MaxenceHeroux/H2GP-2026/README.md

View this project on [CADLAB.io](https://cadlab.io/project/30325). 

# H2GP-2026
