MaxenceHeroux/H2GP-2026/PCB/H30_controler_board.kicad_pcb

## KiCad design PCB/H30_controler_board.kicad_pcb (2026-05-22)

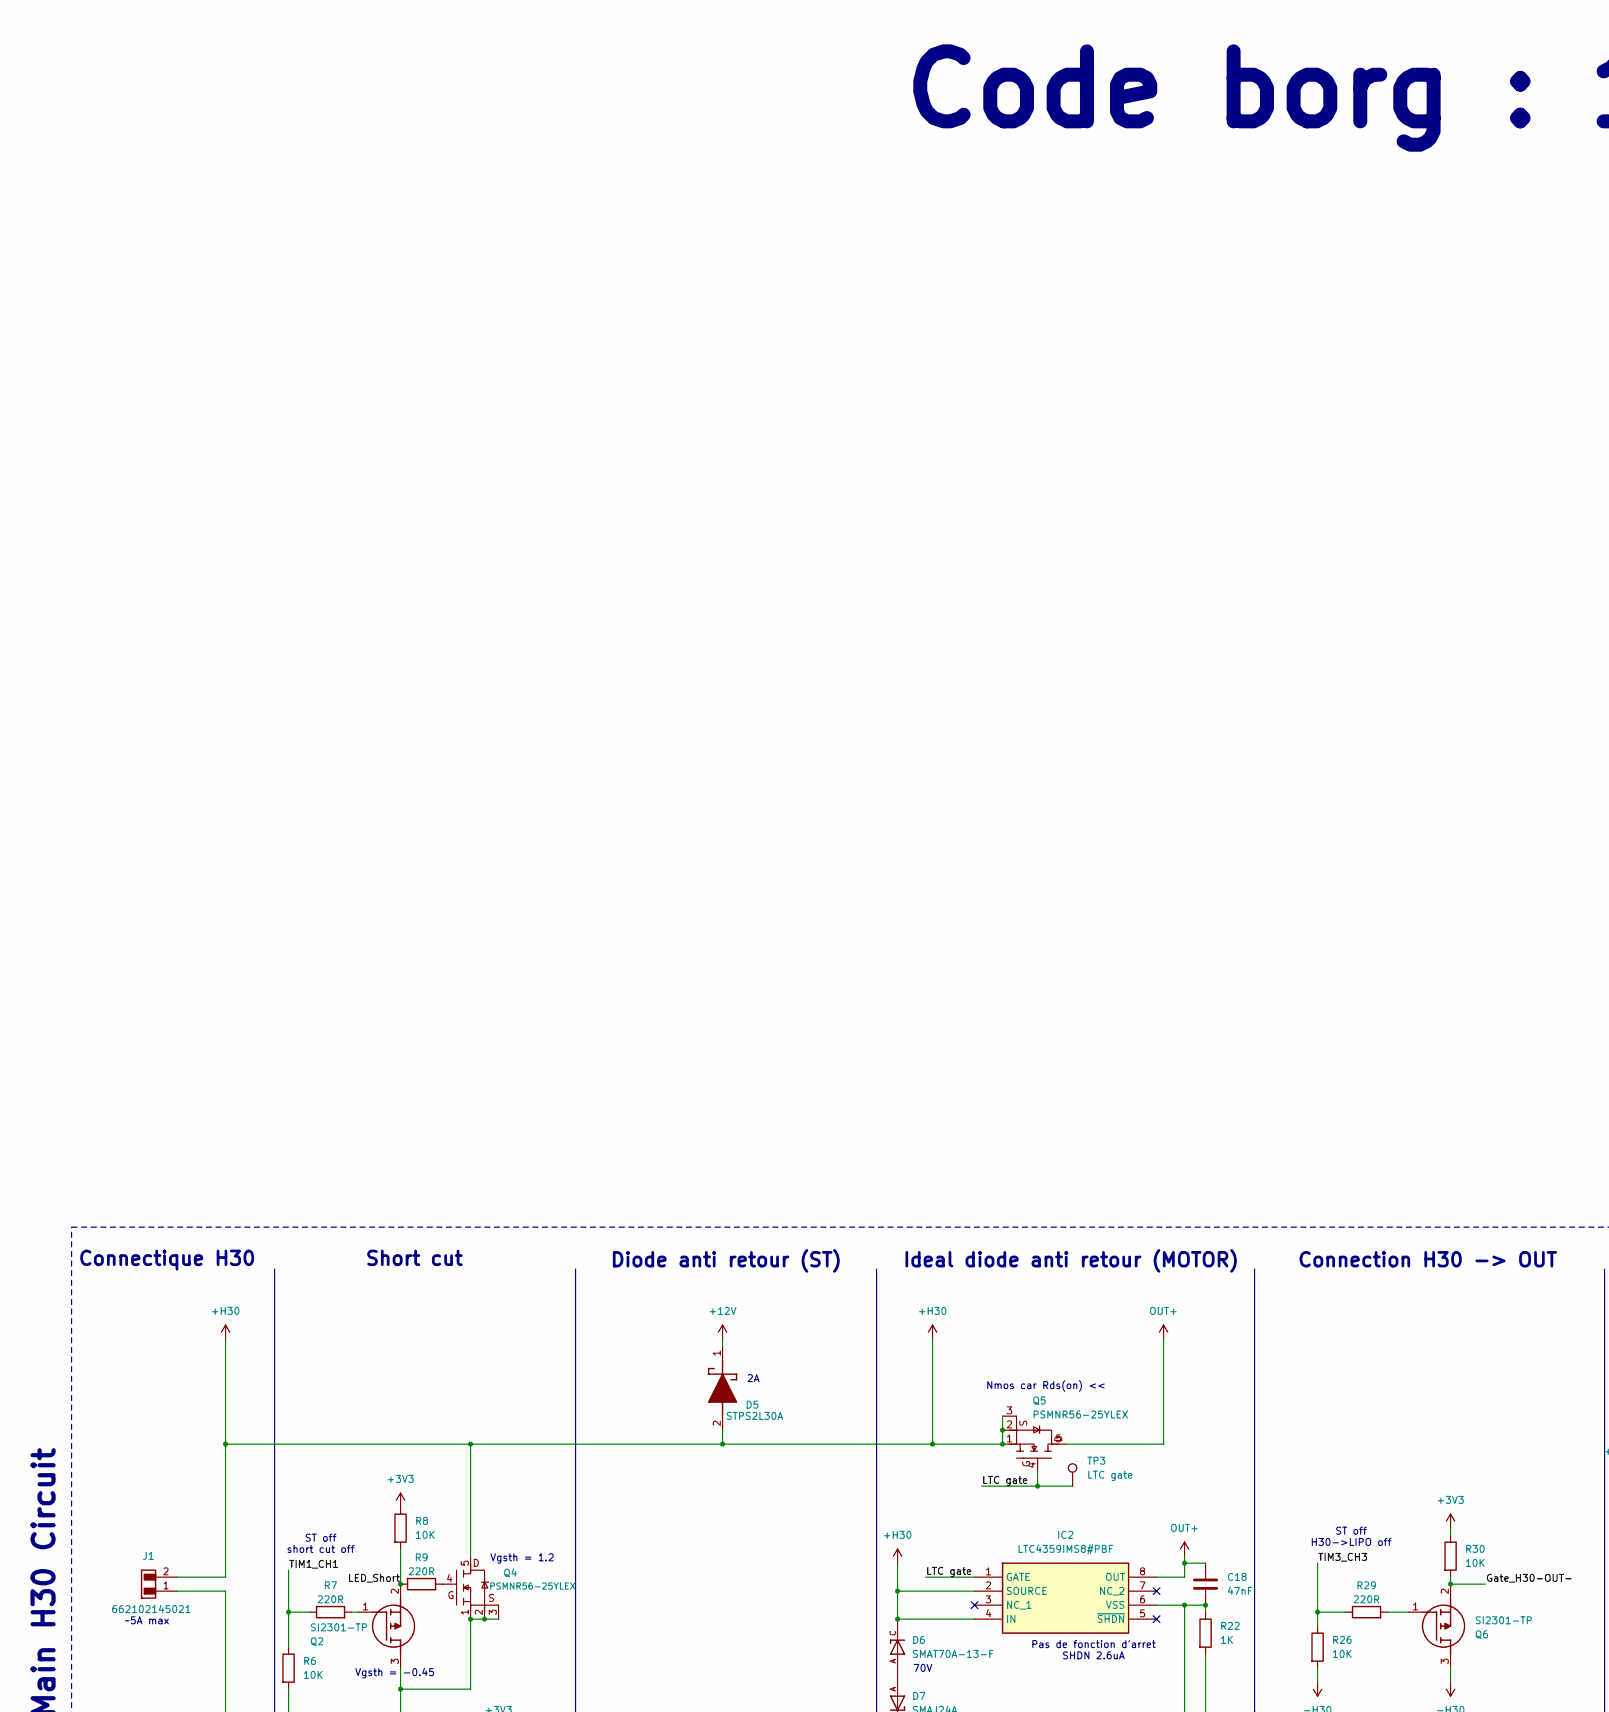
[picture p1: schematic H30_controler_board.kicad_sch, Manager for H30 hydrogene stack, part in row 1, column 1]

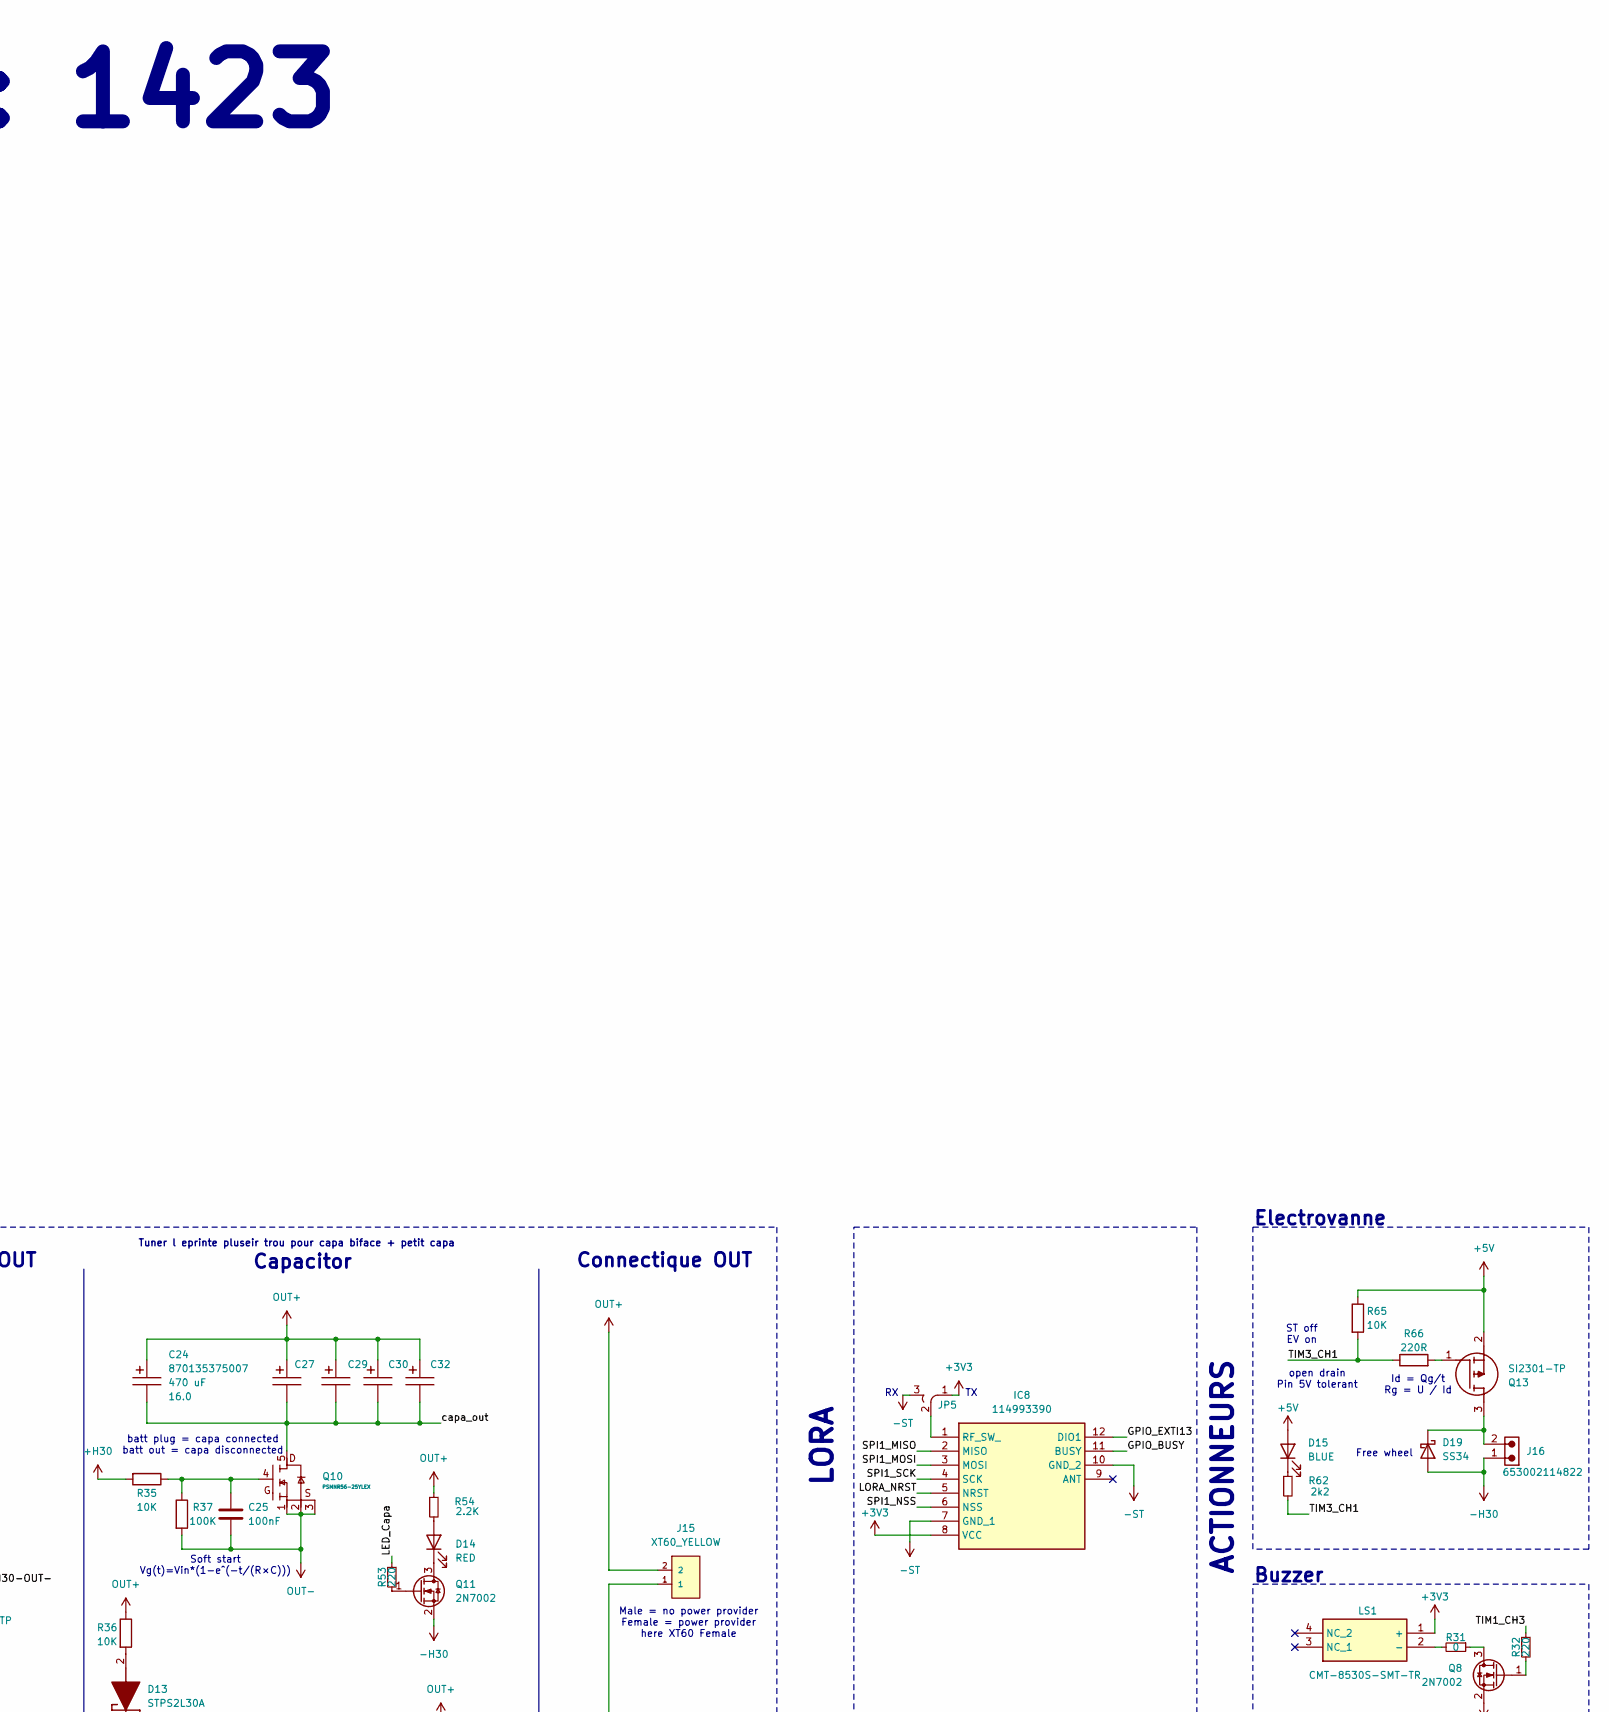
[picture p2: schematic H30_controler_board.kicad_sch, Manager for H30 hydrogene stack, part in row 1, column 2]

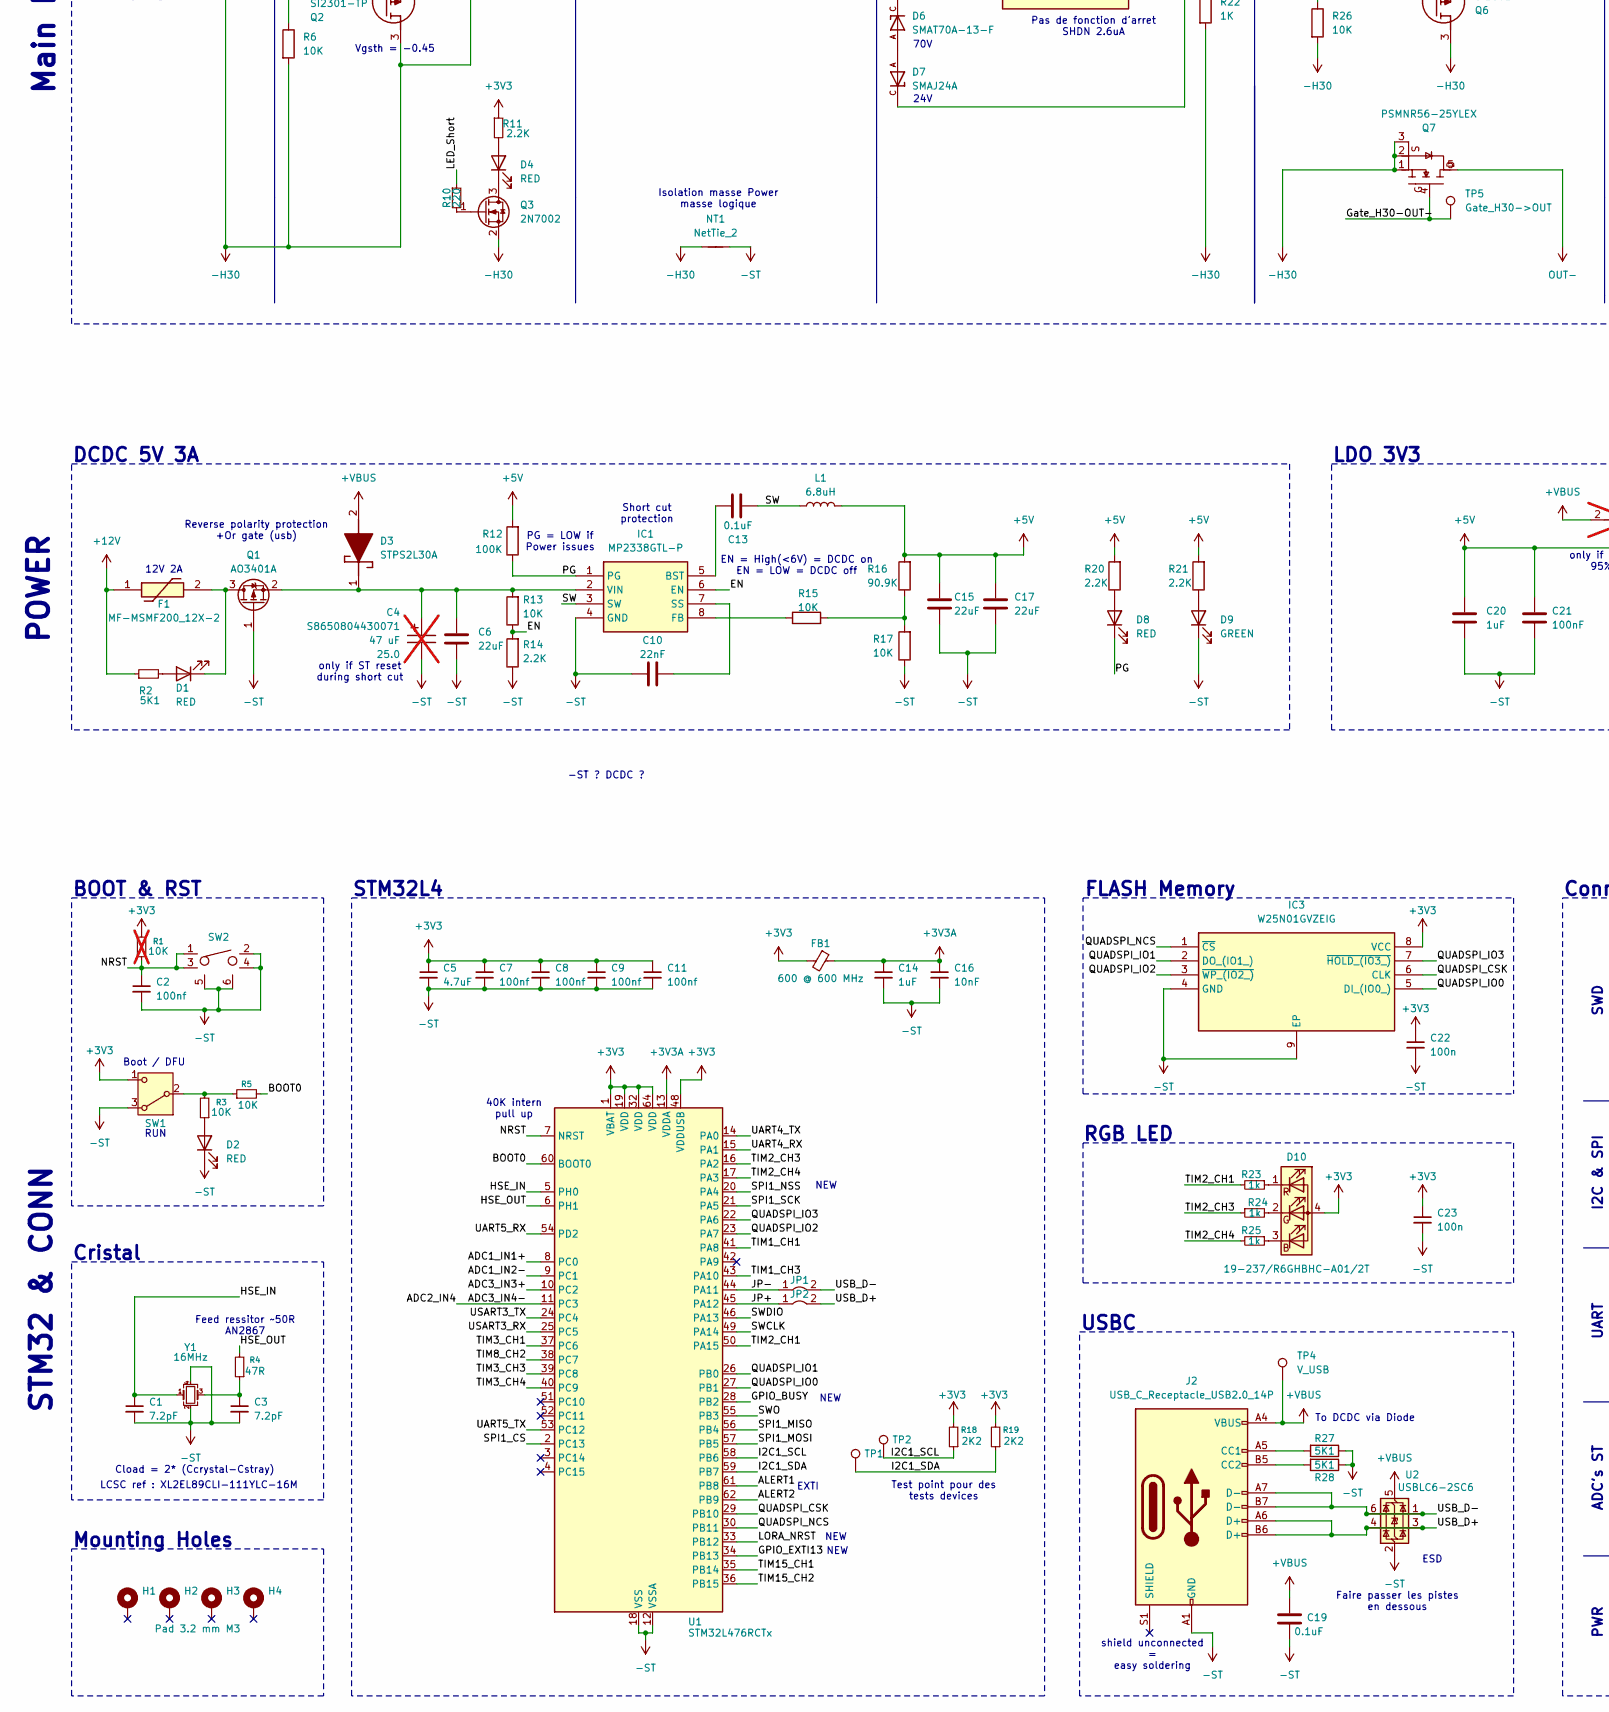
[picture p3: schematic H30_controler_board.kicad_sch, Manager for H30 hydrogene stack, part in row 2, column 1]

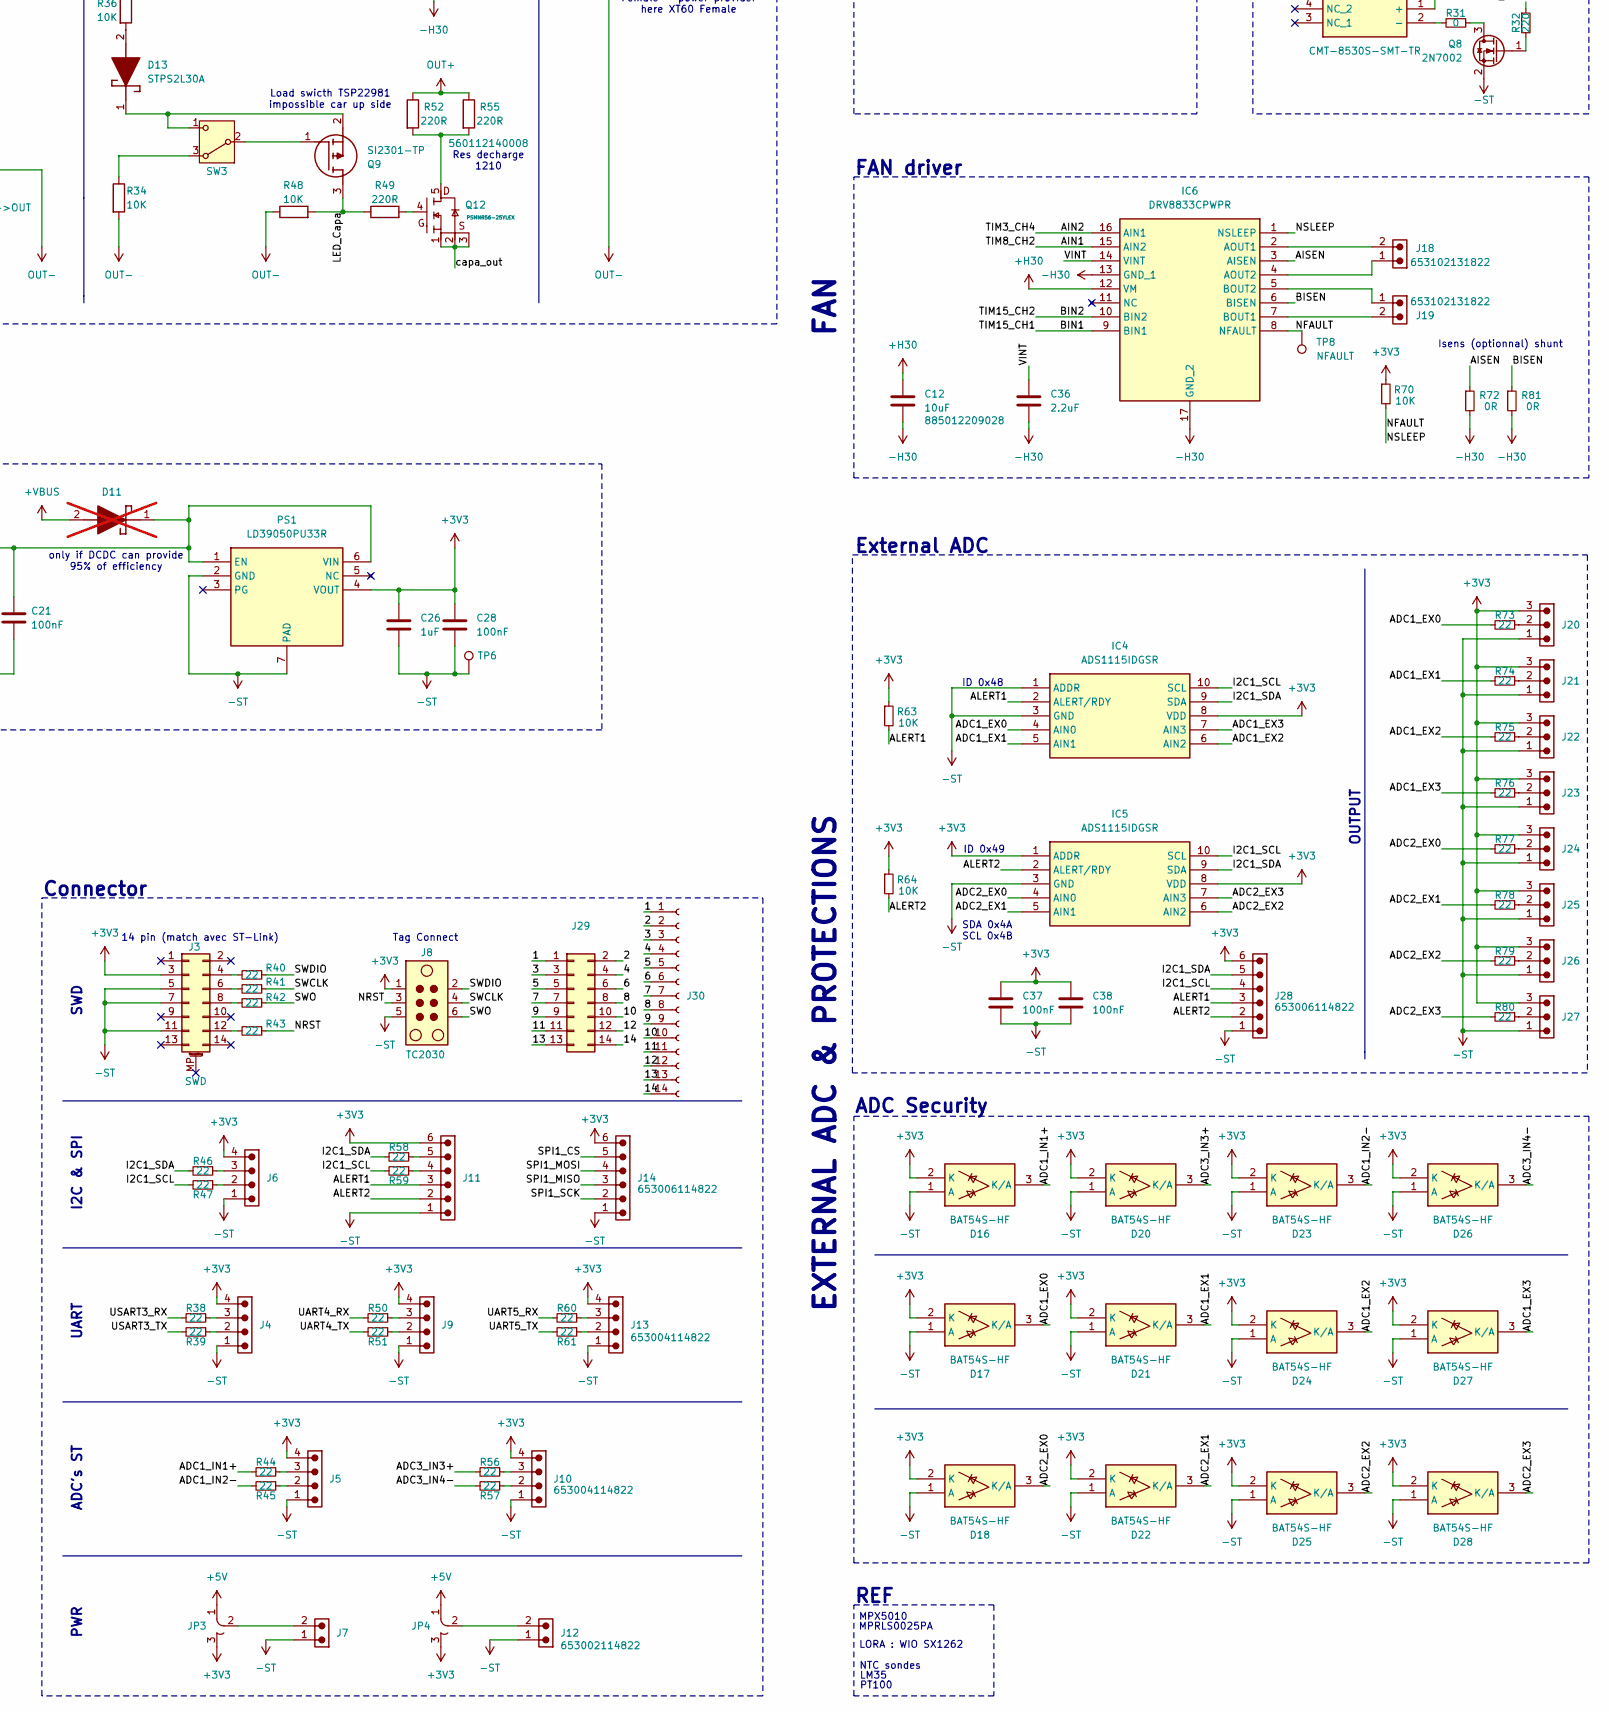
[picture p4: schematic H30_controler_board.kicad_sch, Manager for H30 hydrogene stack, part in row 2, column 2]

Parts:
C1, C3: 7.2pF; C_0603_1608Metric
C2, C7, C9, C11: 100nf; C_0603_1608Metric
C4: 47 uF; CP_Wurth_WCAP-ASLI-D6.3L5.5; Voltage 25.0; Part Number S8650804430071; not fitted
C5: 4.7uF; C_0603_1608Metric
C6, C15, C17: 22uF; C_0603_1608Metric
C8: 100nf; C_0402_1005Metric
C10: 22nF; C_0603_1608Metric
C12: 10uF; C_1210_3225Metric
C13, C19: 0.1uF; C_0603_1608Metric
C14, C20, C26: 1uF; C_0603_1608Metric
C16: 10nF; C_0603_1608Metric
C18: 47nF; C_0603_1608Metric
C21, C25, C28, C37, C38: 100nF; C_0603_1608Metric
C22, C23: 100n; C_0603_1608Metric; LCSC Part # C1525
C24, C27, C29, C30, C32: 470 uF; CP_Wurth_WCAP-PTHT-P5D10L12.5; Voltage 16.0; Part Number 870135375007
C36: 2.2uF; C_0603_1608Metric
D1, D2, D4, D8, D14: RED; LED_0603_1608Metric
D3, D5, D13: STPS2L30A; DIOM5126X265N; Mouser Part Number 511-STPS2L30A
D6: SMAT70A-13-F; DIOM5226X230N; PARTREV 11 - 2
D7: SMAJ24A; DIOM4325X250N; PARTREV S2102
D9: GREEN; LED_0603_1608Metric
D10: 19-237/R6GHBHC-A01/2T; 19237R6GHBHCA012T; LCSC Part # C60105
D11: STPS2L30A; DIOM5126X265N; Mouser Part Number 511-STPS2L30A; not fitted
D15: BLUE; LED_0603_1608Metric
D16, D17, D18, D20, D21, D22, D23, D24, D25, D26, D27, D28: BAT54S-HF; SOT95P240X115-3N; Mouser Part Number 750-BAT54S-HF
D19: SS34; D_SMA
F1: MF-MSMF200_12X-2; MFMSMF20012X2; Manufacturer_Part_Number MF-MSMF200/12X-2
FB1: 600 @ 600 MHz; L_0805_2012Metric; LCSC Part # C1017
H1, H2, H4: MountingHole_Pad; MountingHole_3.2mm_M3_Pad_Via
H3: Pad 3.2 mm M3; MountingHole_3.2mm_M3_Pad_Via
IC1: MP2338GTL-P; SOTFL50P160X60-8N; Mouser Part Number 946-MP2338GTL-P
IC2: LTC4359IMS8#PBF; SOP65P490X110-8N; Mouser Part Number 584-LTC4359IMS8#PBF
IC3: W25N01GVZEIG; SON127P800X600X80-9N-D; Mouser Part Number 454-W25N01GVZEIG
IC4, IC5: ADS1115IDGSR; SOP50P490X110-10N; Mouser Part Number 595-ADS1115IDGSR
IC6: DRV8833CPWPR; SOP65P640X120-17N; Mouser Part Number 595-DRV8833CPWPR
IC8: 114993390; Mouser Part Number 713-114993390
J1: 662102145021; J_Wurth_WR-MPC3_662102145021; Working Voltage (V (AC)) 250
J2: USB_C_Receptacle_USB2.0_14P; USBC
J3: SWD; PinHeader_2x07_P1.27mm_Vertical
J4, J5, J6, J9, J10, J13: 653004114822; J_Wurth_WR-WTB_653004114822; Working Voltage (V (AC)) 125
J7, J12, J16: 653002114822; J_Wurth_WR-WTB_653002114822; Working Voltage (V (AC)) 125
J8: TC2030; Tag-Connect_TC2030-IDC-NL_2x03_P1.27mm_Vertical
J11, J14, J28: 653006114822; J_Wurth_WR-WTB_653006114822; Working Voltage (V (AC)) 125
J15: XT60_YELLOW; AMASS_XT60PB-F; PARTREV 1.2
J18, J19: 653102131822; J_Wurth_WR-WTB_653102131822; Working Voltage (V (AC)) 125
J20, J21, J22, J23, J24, J25, J26, J27: 653003114822; J_Wurth_WR-WTB_653003114822; Working Voltage (V (AC)) 125
J29: Conn_02x07_Odd_Even; PinSocket_2x07_P1.27mm_Vertical
J30: Conn_01x14_Socket; PinSocket_2x07_P2.54mm_Vertical
JP1, JP2: Jumper_0603
JP3, JP4, JP5: Jumper_3points_0402
L1: 6.8uH; INDPM5752X200N
LS1: CMT-8530S-SMT-TR; CMT8530SSMTTR; Mouser Part Number 490-CMT-8530S-SMT-TR
NT1: NetTie_2; NetTie-2_SMD_Pad2.0mm
PS1: LD39050PU33R; SON95P300X300X100-7N-D; Mouser Part Number 511-LD39050PU33R
Q1: AO3401A; SOT-23
Q2, Q6, Q9, Q13: SI2301-TP; SOT95P237X125-3N; Mouser Part Number 833-SI2301-TP
Q3, Q8, Q11: 2N7002; SOT-23
Q4, Q5, Q7, Q10, Q12: PSMNR56-25YLEX; PSMNR5830YLHX
R1: 10K; R_0402_1005Metric; not fitted
R2: 5K1; R_0603_1608Metric; LCSC Part # C25092
R3, R5, R6, R8, R13, R15, R17, R26, R30, R34, R35, R36, R48, R65: 10K; R_0603_1608Metric
R4: 47R; R_0603_1608Metric
R7, R9, R29, R49, R66: 220R; R_0603_1608Metric
R10, R32, R53: 220; R_0603_1608Metric; LCSC Part # C25092
R11, R54: 2.2K; R_0603_1608Metric; LCSC Part # C25092
R12, R37: 100K; R_0603_1608Metric
R14, R20, R21: 2.2K; R_0603_1608Metric
R16: 90.9K; R_0603_1608Metric
R18, R19: 2K2; R_0603_1608Metric
R22: 1K; R_0603_1608Metric
R23, R24, R25: 1k; R_0603_1608Metric; LCSC Part # C11702
R27, R28: 5K1; R_0603_1608Metric
R31: 0; R_0603_1608Metric; LCSC Part # C25092
R38, R39, R40, R41, R42, R43, R44, R45, R46, R47, R50, R51, R56, R57, R58, R59, R60, R61, R73, R74, R75, R76, R77, R78, R79, R80: 22; R_0402_1005Metric; LCSC Part # C25092
R52, R55: 220R; R_1210_3225Metric
R62: 2k2; R_0603_1608Metric; LCSC Part # C25092
R63, R64, R70: 10K; R_0603_1608Metric; LCSC Part # C25092
R72, R81: 0R; R_0603_1608Metric; LCSC Part # C25092
SW1, SW3: SW_Nidec_CAS-120A1; 450404015514
SW2: SKSG
TP1: SDA; TestPoint_Pad_D1.5mm
TP2: SCL; TestPoint_Pad_D1.5mm
TP3: LTC gate; TestPoint_Pad_D1.5mm
TP4: V_USB; TestPoint_Pad_D1.5mm
TP5: Gate_H30->OUT; TestPoint_Pad_D1.5mm
TP6: V_Reverse; TestPoint_Pad_D1.5mm
TP8: NFAULT; TestPoint_Pad_D1.5mm
U1: STM32L476RCTx; LQFP-64_10x10mm_P0.5mm
U2: USBLC6-2SC6; SOT-23-6
Y1: 16MHz; NX3225SA16000000MHZB3

Connections:
+3V3: C5.1, C7.1, C8.1, C9.1, C11.1, C22.1, C23.1, C26.1, C28.1, C37.1, C38.1, D10.4 (A), D16.2 (K), D17.2 (K), D18.2 (K), D20.2 (K), D21.2 (K), D22.2 (K), D23.2 (K), D24.2 (K), D25.2 (K), D26.2 (K), D27.2 (K), D28.2 (K), FB1.2, IC3.8 (VCC), IC4.8 (VDD), IC5.1 (ADDR), IC5.8 (VDD), IC8.8 (VCC), J3.3, J4.4, J5.4, J6.4, J8.1, J9.4, J10.4, J11.6, J13.4, J14.6, J20.3, J21.3, J22.3, J23.3, J24.3, J25.3, J26.3, J27.3, J28.6, JP3.3, JP4.3, JP5.1, LS1.1 (+), PS1.4 (VOUT), R1.2, R8.1, R11.1, R18.2, R19.2, R30.1, R63.1, R64.1, R70.1, SW1.1 (C), U1.1 (VBAT), U1.19 (VDD), U1.32 (VDD), U1.48 (VDDUSB), U1.64 (VDD); also elsewhere on the board
+3V3A: C14.1, C16.1, FB1.1, U1.13 (VDDA)
+5V: C15.1, C17.1, C20.1, C21.1, D11.1 (K), D15.2 (A), JP3.1, JP4.1, L1.2, PS1.1 (EN), PS1.6 (VIN), Q13.2 (S), R12.2, R16.2, R20.2, R21.2, R65.1
+12V: D5.1 (K), F1.1, R2.1
+H30: C12.1, D5.2 (A), D6.C, IC2.2 (SOURCE), IC2.4 (IN), IC6.12 (VM), J1.2, Q4.5 (D), Q4.6, Q5.1 (S), Q5.2 (S), Q5.3 (S), R35.2
+VBUS: C19.1, D3.2 (A), D11.2 (A), J2.A4 (VBUS), J2.A9 (VBUS), J2.B4 (VBUS), J2.B9 (VBUS), TP4.1, U2.5 (VBUS)
-H30: C12.2, C36.2, D19.2 (A), IC6.13 (GND_1), IC6.17 (GND_2), J1.1, J16.1, J19.MP1, NT1.2, Q2.3 (D), Q3.2 (S), Q4.1 (S), Q4.2 (S), Q4.3 (S), Q6.3 (D), Q7.1 (S), Q7.2 (S), Q7.3 (S), Q11.2 (S), R6.2, R22.2, R26.2, R72.2, R81.2
-ST: C1.2, C2.2, C3.2, C4.2, C5.2, C6.2, C7.2, C8.2, C9.2, C10.2, C11.2, C14.2, C15.2, C16.2, C17.2, C19.2, C20.2, C21.2, C22.2, C23.2, C26.2, C28.2, C37.2, C38.2, D2.1 (K), D9.1 (K), D16.1 (A), D17.1 (A), D18.1 (A), D20.1 (A), D21.1 (A), D22.1 (A), D23.1 (A), D24.1 (A), D25.1 (A), D26.1 (A), D27.1 (A), D28.1 (A), IC1.4 (GND), IC3.4 (GND), IC3.9 (EP), IC4.1 (ADDR), IC4.3 (GND), IC5.3 (GND), IC8.7 (GND_1), IC8.10 (GND_2), J2.A1 (GND), J2.A12 (GND), J2.B1 (GND), J2.B12 (GND), J3.5, J3.7, J3.11, J4.1, J5.1, J6.1, J7.1, J8.5, J9.1, J10.1, J11.1, J12.1, J13.1, J14.1, J20.1, J21.1, J22.1, J23.1, J24.1, J25.1, J26.1, J27.1, J28.1, JP5.3, NT1.1, PS1.2 (GND), PS1.7 (PAD), Q1.1 (G), Q8.2 (S), R14.1, R17.1, R27.1, R28.1, SW1.3 (A), SW2.2, SW2.4, SW2.5, SW2.6, TP6.1, U1.12 (VSSA), U1.18 (VSS), U1.31 (VSS), U1.47 (VSS), U1.63 (VSS), U2.2 (GND), Y1.2, Y1.4
/1: J29.1, J30.1
/2: J29.2, J30.2
/3: J29.3, J30.3
/4: J29.4, J30.4
/5: J29.5, J30.5
/6: J29.6, J30.6
/7: J29.7, J30.7
/8: J29.8, J30.8
/9: J29.9, J30.9
/10: J29.10, J30.10
/11: J29.11, J30.11
/12: J29.12, J30.12
/13: J29.13, J30.13
/14: J29.14, J30.14
/ADC1_EX0: D17.3 (K/A), IC4.4 (AIN0), R73.2
/ADC1_EX1: D21.3 (K/A), IC4.5 (AIN1), R74.2
/ADC1_EX2: D24.3 (K/A), IC4.6 (AIN2), R75.2
/ADC1_EX3: D27.3 (K/A), IC4.7 (AIN3), R76.2
/ADC1_IN1+: D16.3 (K/A), R44.2, U1.8 (PC0)
/ADC1_IN2-: D23.3 (K/A), R45.2, U1.9 (PC1)
/ADC2_EX0: D18.3 (K/A), IC5.4 (AIN0), R77.2
/ADC2_EX1: D22.3 (K/A), IC5.5 (AIN1), R78.2
/ADC2_EX2: D25.3 (K/A), IC5.6 (AIN2), R79.2
/ADC2_EX3: D28.3 (K/A), IC5.7 (AIN3), R80.2
/ADC2_IN4: D26.3 (K/A), R57.2, U1.11 (PC3)
/ADC3_IN3+: D20.3 (K/A), R56.2, U1.10 (PC2)
/AIN1: IC6.15 (AIN2), U1.38 (PC7)
/AIN2: IC6.16 (AIN1), U1.40 (PC9)
/AISEN: IC6.3 (AISEN), R72.1
/ALERT1: IC4.2 (ALERT/RDY), J11.3, J28.3, R63.2, U1.61 (PB8)
/ALERT2: IC5.2 (ALERT/RDY), J11.2, J28.2, R64.2, U1.62 (PB9)
/BIN1: IC6.9 (BIN1), U1.35 (PB14)
/BIN2: IC6.10 (BIN2), U1.36 (PB15)
/BISEN: IC6.6 (BISEN), R81.1
/BOOT0: R5.2, U1.60 (BOOT0)
/EN: IC1.6 (EN), R13.1, R14.2
/GPIO_BUSY: IC8.11 (BUSY), U1.28 (PB2)
/GPIO_EXTI13: IC8.12 (DIO1), U1.34 (PB13)
/Gate_H30-OUT-: Q6.2 (S), Q7.4 (G), R30.2, TP5.1
/HSE_IN: C1.1, U1.5 (PH0), Y1.1
/HSE_OUT: R4.2, U1.6 (PH1)
/I2C1_SCL: IC4.10 (SCL), IC5.10 (SCL), J28.4, R18.1, R47.2, R59.2, TP2.1, U1.58 (PB6); also elsewhere on the board
/I2C1_SDA: IC4.9 (SDA), IC5.9 (SDA), J28.5, R19.1, R46.2, R58.2, TP1.1, U1.59 (PB7); also elsewhere on the board
/JP+: JP2.1, U1.45 (PA12)
/JP-: JP1.1, U1.44 (PA11)
/LED_Capa: Q9.3 (D), R48.2, R49.1, R53.1
/LED_Short: Q2.2 (S), R8.2, R9.1, R10.1
/LORA_NRST: IC8.5 (NRST), U1.33 (PB12)
/LTC gate: IC2.1 (GATE), Q5.4 (G), TP3.1
/NFAULT: IC6.1 (NSLEEP), IC6.8 (NFAULT), R70.2, TP8.1
/NRST: C2.1, J8.3, R1.1, R43.1, SW2.1, SW2.3, U1.7 (NRST)
/PG: D8.1 (K), IC1.1 (PG), R12.1
/QUADSPI_CSK: IC3.6 (CLK), U1.29 (PB10)
/QUADSPI_IO0: IC3.5 (DI_(IO0_)), U1.27 (PB1)
/QUADSPI_IO1: IC3.2 (DO_(IO1_)), U1.26 (PB0)
/QUADSPI_IO2: IC3.3 (~WP_(IO2_)), U1.23 (PA7)
/QUADSPI_IO3: IC3.7 (~HOLD_(IO3_)), U1.22 (PA6)
/QUADSPI_NCS: IC3.1 (~CS), U1.30 (PB11)
/SPI1_CS: J14.5, U1.2 (PC13)
/SPI1_MISO: IC8.2 (MISO), J14.3, U1.56 (PB4)
/SPI1_MOSI: IC8.3 (MOSI), J14.4, U1.57 (PB5)
/SPI1_NSS: IC8.6 (NSS), U1.20 (PA4)
/SPI1_SCK: IC8.4 (SCK), J14.2, U1.21 (PA5)
/SW: C13.2, IC1.3 (SW), L1.1
/SWCLK: J8.4, R41.1, U1.49 (PA14)
/SWDIO: J8.2, R40.1, U1.46 (PA13)
/SWO: J8.6, R42.1, U1.55 (PB3)
/TIM1_CH1: R6.1, R7.1, U1.41 (PA8)
/TIM1_CH3: R32.1, U1.43 (PA10)
/TIM2_CH1: R23.2, U1.50 (PA15)
/TIM2_CH3: R24.1, U1.16 (PA2)
/TIM2_CH4: R25.2, U1.17 (PA3)
/TIM3_CH1: R62.2, R65.2, R66.1, U1.37 (PC6)
/TIM3_CH3: R26.1, R29.1, U1.39 (PC8)
/UART4_RX: R50.2, U1.15 (PA1)
/UART4_TX: R51.2, U1.14 (PA0)
/UART5_RX: R60.2, U1.54 (PD2)
/UART5_TX: R61.2, U1.53 (PC12)
/USART3_RX: R38.2, U1.25 (PC5)
/USART3_TX: R39.2, U1.24 (PC4)
/USB_D+: J2.A6 (D+), J2.B6 (D+), JP2.2, U2.3 (I/O2), U2.4 (I/O2)
/USB_D-: J2.A7 (D-), J2.B7 (D-), JP1.2, U2.1 (I/O1), U2.6 (I/O1)
/VINT: C36.1, IC6.14 (VINT)
/capa_out: C24.2, C27.2, C29.2, C30.2, C32.2, Q10.5 (D), Q10.6, Q12.1 (S), Q12.2 (S), Q12.3 (S)
unnamed: C3.1, R4.1, Y1.3
unnamed: D1.2 (A), R2.2
unnamed: D1.1 (K), F1.2, Q1.3 (D)
unnamed: D2.2 (A), R3.1
unnamed: C4.1, C6.1, D3.1 (K), IC1.2 (VIN), Q1.2 (S), R13.2
unnamed: D4.2 (A), R11.2
unnamed: D4.1 (K), Q3.3 (D)
unnamed: D6.A, D7.A
unnamed: D8.2 (A), R20.1
unnamed: D9.2 (A), R21.1
unnamed: D10.3 (BK), R25.1
unnamed: D10.2 (GK), R24.2
unnamed: D10.1 (RK), R23.1
unnamed: D13.2 (A), R36.2
unnamed: D13.1 (K), Q9.2 (S), SW3.1 (C)
unnamed: D14.2 (A), R54.2
unnamed: D14.1 (K), Q11.3 (D)
unnamed: D15.1 (K), R62.1
unnamed: D19.1 (K), J16.2, Q13.3 (D)
unnamed: C13.1, IC1.5 (BST)
unnamed: IC1.8 (FB), R15.1
unnamed: C10.1, IC1.7 (SS)
unnamed: C18.2, D7.C, IC2.6 (VSS), R22.1
unnamed: IC6.2 (AOUT1), J18.2
unnamed: IC6.4 (AOUT2), J18.1
unnamed: IC6.7 (BOUT1), J19.2
unnamed: IC6.5 (BOUT2), J19.1
unnamed: IC8.1 (RF_SW_), JP5.2
unnamed: J2.A5 (CC1), R27.2
unnamed: J2.B5 (CC2), R28.2
unnamed: J3.4, R40.2
unnamed: J3.6, R41.2
unnamed: J3.8, R42.2
unnamed: J3.12, R43.2
unnamed: J4.2, R39.1
unnamed: J4.3, R38.1
unnamed: J5.2, R45.1
unnamed: J5.3, R44.1
unnamed: J6.2, R47.1
unnamed: J6.3, R46.1
unnamed: J7.2, JP3.2
unnamed: J9.2, R51.1
unnamed: J9.3, R50.1
unnamed: J10.2, R57.1
unnamed: J10.3, R56.1
unnamed: J11.4, R59.1
unnamed: J11.5, R58.1
unnamed: J12.2, JP4.2
unnamed: J13.2, R61.1
unnamed: J13.3, R60.1
unnamed: J20.2, R73.1
unnamed: J21.2, R74.1
unnamed: J22.2, R75.1
unnamed: J23.2, R76.1
unnamed: J24.2, R77.1
unnamed: J25.2, R78.1
unnamed: J26.2, R79.1
unnamed: J27.2, R80.1
unnamed: LS1.2 (-), R31.2
unnamed: Q2.1 (G), R7.2
unnamed: Q3.1 (G), R10.2
unnamed: Q4.4 (G), R9.2
unnamed: Q6.1 (G), R29.2
unnamed: Q8.3 (D), R31.1
unnamed: Q8.1 (G), R32.2
unnamed: Q9.1 (G), SW3.2 (B)
unnamed: C25.1, Q10.4 (G), R35.1, R37.1
unnamed: Q11.1 (G), R53.2
unnamed: Q12.5 (D), Q12.6, R52.2, R55.2
unnamed: Q12.4 (G), R49.2
unnamed: Q13.1 (G), R66.2
unnamed: R15.2, R16.1, R17.2
unnamed: R3.2, R5.1, SW1.2 (B)
unnamed: R34.1, SW3.3 (A)
OUT+: C18.1, C24.1, C27.1, C29.1, C30.1, C32.1, IC2.8 (OUT), J15.2, LS1.3 (NC_1), Q5.5 (D), Q5.6, R36.1, R52.1, R54.1, R55.1
OUT-: C25.2, J15.1, Q7.5 (D), Q7.6, Q10.1 (S), Q10.2 (S), Q10.3 (S), R34.2, R37.2, R48.1

Notes on the sheet:
Faire passer les pistes en dessous
OUTPUT
Nmos car Rds(on) <<
Boot / DFU
Isolation masse Power masse logique
Tag Connect
SWD
shield unconnected = easy soldering
ID 0x49
ID 0x48
To DCDC via Diode
ST off EV on
Code borg : 1423
EXTI
PWR
Electrovanne
Reverse polarity protection +Or gate (usb)
Connectique OUT
Short cut
Res decharge 1210
Main H30 Circuit
MPRLS0025PA
LORA
12V 2A
only if DCDC can provide 95% of efficiency
Mounting Holes
LM35
NEW
Cload = 2* (Ccrystal-Cstray)
Test point pour des tests devices
PT100
Load swicth TSP22981 impossible car up side
UART
DCDC 5V 3A
Short cut protection
Tuner l eprinte pluseir trou pour capa biface + petit capa
NTC sondes
External ADC
Diode anti retour (ST)
batt plug = capa connected batt out = capa disconnected
STM32L4
EXTERNAL ADC & PROTECTIONS
LCSC ref : XL2EL89CLI-111YLC-16M
Connectique H30
-ST ? DCDC ?
14 pin (match avec ST-Link)
Buzzer
only if ST reset during short cut
Connection H30 -> OUT
Ideal diode anti retour (MOTOR)
ESD
FAN driver
Capacitor
70V
MPX5010
Isens (optionnal) shunt
STM32 & CONN
Free wheel
ST off short cut off
Connector
24V
POWER
ACTIONNEURS
~5A max
USBC
open drain Pin 5V tolerant
RUN
Cristal
EN = High(<6V) = DCDC on EN = LOW = DCDC off
Male = no power provider Female = power provider here XT60 Female
Soft start Vg(t)=Vin*(1−e^(−t/(R×C)))
RGB LED
Pas de fonction d'arret SHDN 2.6uA
I2C & SPI
40K intern pull up
SDA 0x4A SCL 0x4B
LDO 3V3
REF
ST off H30->LIPO off
PG = LOW if Power issues
ADC Security
Vgsth = 1.2
BOOT & RST
Feed ressitor ~50R AN2867
FAN
Vgsth = -0.45
ADC's ST
LORA : WIO SX1262
Id = Qg/t Rg = U / Id
FLASH Memory

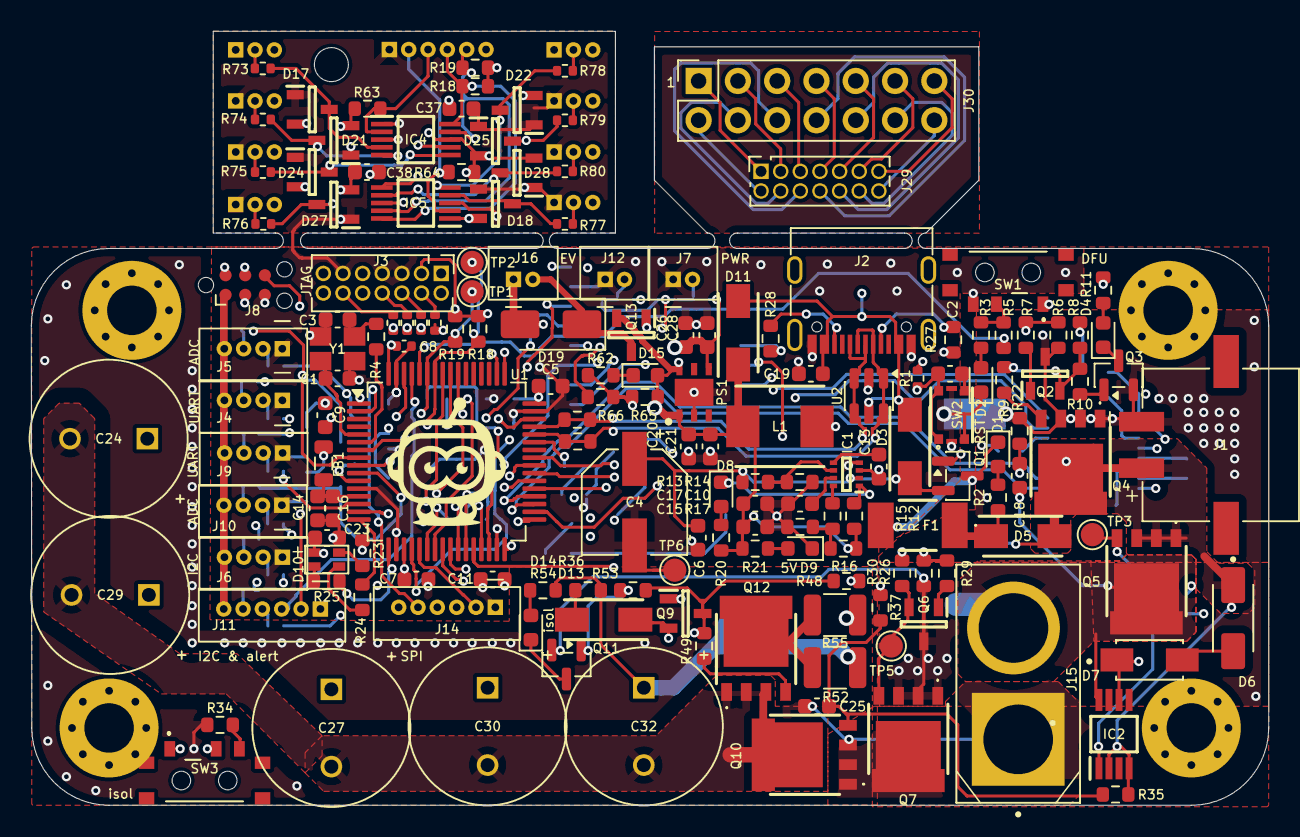
[picture p5: board H30_controler_board.kicad_pcb from above]

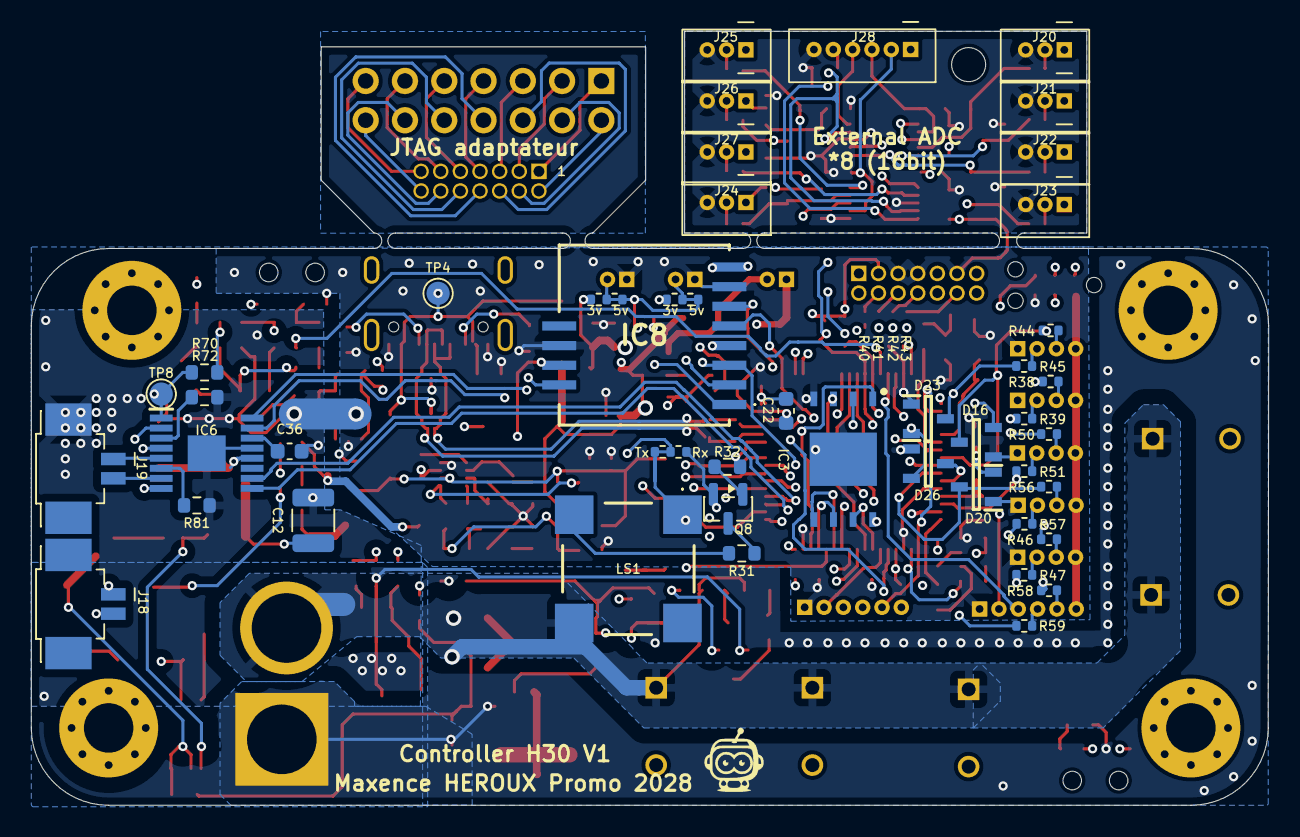
[picture p6: board H30_controler_board.kicad_pcb from below]

Board: 4 copper layers, 80.0 x 50.0 mm, 213 parts (46 on the bottom side), 164 nets.

Other parts of the board:
R18#2, R19#2: 2K2; R_0603_1608Metric

Their connections:
+3V3: R18#2.2, R19#2.2; also elsewhere on the board
/I2C1_SCL: R18#2.1; also elsewhere on the board
/I2C1_SDA: R19#2.1; also elsewhere on the board
