MaxenceHeroux/H2GP-2026/H30_board_manager.ioc

Mcu.UserName=STM32L476RCTx
PA0.Signal=UART4_TX
PA1.Signal=UART4_RX
PA10.Signal=S_TIM1_CH3
PA11.Signal=USB_OTG_FS_DM
PA12.Signal=USB_OTG_FS_DP
PA2.Signal=S_TIM2_CH3
PA3.Signal=S_TIM2_CH4
PA4.GPIO_Label=SPI1_NSS
PA4.Signal=GPIO_Output
PA5.Signal=SPI1_SCK
PA6.Signal=QUADSPI_BK1_IO3
PA7.Signal=QUADSPI_BK1_IO2
PA8.GPIO_Label=CC
PA8.Signal=GPIO_Output
PB0.Signal=QUADSPI_BK1_IO1
PB1.Signal=QUADSPI_BK1_IO0
PB10.Signal=QUADSPI_CLK
PB11.Signal=QUADSPI_NCS
PB12.GPIO_Label=LORA_NRST
PB12.Signal=GPIO_Output
PB13.Signal=GPXTI13
PB14.Signal=S_TIM15_CH1
PB15.Signal=S_TIM15_CH2
PB2.GPIO_Label=GPIO_BUSY
PB2.Signal=GPIO_Input
PB5.Signal=SPI1_MOSI
PB6.Signal=I2C1_SCL
PB7.Signal=I2C1_SDA
PB8.Signal=GPXTI8
PB9.Signal=GPXTI9
PC0.Signal=ADCx_IN1
PC1.Signal=ADCx_IN2
PC12.Signal=UART5_TX
PC13.GPIO_Label=SPI1_CS
PC13.Signal=GPIO_Output
PC2.Signal=ADCx_IN3
PC3.Signal=ADCx_IN4
PC4.Signal=USART3_TX
PC5.Signal=USART3_RX
PC6.GPIO_Label=EV
PC6.Signal=GPIO_Output
PC7.Signal=S_TIM8_CH2
PC8.GPIO_Label=H30_ESC
PC8.Signal=GPIO_Output
PC9.Signal=S_TIM3_CH4
PD2.Signal=UART5_RX
