MaxenceHeroux/H2GP-2026/Core/Inc/main.h

#define SPI1_CS_Pin GPIO_PIN_13
#define SPI1_CS_GPIO_Port GPIOC
#define SPI1_NSS_Pin GPIO_PIN_4
#define SPI1_NSS_GPIO_Port GPIOA
#define GPIO_BUSY_Pin GPIO_PIN_2
#define GPIO_BUSY_GPIO_Port GPIOB
#define LORA_NRST_Pin GPIO_PIN_12
#define LORA_NRST_GPIO_Port GPIOB
#define EV_Pin GPIO_PIN_6
#define EV_GPIO_Port GPIOC
#define H30_ESC_Pin GPIO_PIN_8
#define H30_ESC_GPIO_Port GPIOC
#define CC_Pin GPIO_PIN_8
#define CC_GPIO_Port GPIOA
