MaxenceHeroux/H2GP-2026/PDMS_I2C/Src/platform.c

/*
 ***************************************************************************************************
 * This file is part of Sensors SDK:
 * https://www.we-online.com/sensors, https://github.com/WurthElektronik/Sensors-SDK_STM32
 *
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
 * THIS SOURCE CODE IS PROTECTED BY A LICENSE.
 * FOR MORE INFORMATION PLEASE CAREFULLY READ THE LICENSE AGREEMENT FILE (license_terms_wsen_sdk.pdf)
 * LOCATED IN THE ROOT DIRECTORY OF THIS DRIVER PACKAGE.
 *
 * COPYRIGHT (c) 2022 Würth Elektronik eiSos GmbH & Co. KG
 *
 ***************************************************************************************************
 */

/**
 * @file
 * @brief Contains platform-specific functions.
 */

#include "../Inc/platform.h"

#include "usart.h"
#include <string.h>
#include "../../LogLib/log.h"


#ifdef STM32L476xx
#include "stm32l4xx_hal.h"
#endif

#ifdef HAL_I2C_MODULE_ENABLED
static HAL_StatusTypeDef I2Cx_ReadBytes(I2C_HandleTypeDef* handle, uint8_t addr, uint16_t reg, uint16_t numBytesToRead, WE_i2cProtocol_t protocol, uint16_t timeout, uint8_t* value);
static HAL_StatusTypeDef I2Cx_WriteBytes(I2C_HandleTypeDef* handle, uint8_t addr, uint16_t reg, uint16_t numBytesToWrite, WE_i2cProtocol_t protocol, uint16_t timeout, uint8_t* value);
#endif /* HAL_I2C_MODULE_ENABLED */


/**
 * @brief Read data starting from the addressed register
 * @param[in] interface Sensor interface
 * @param[in] regAdr The register address to read from
 * @param[in] numBytesToRead Number of bytes to read
 * @param[out] data The read data will be stored here
 * @retval Error code
 */
inline int8_t WE_ReadReg(WE_sensorInterface_t* interface, uint8_t regAdr, uint16_t numBytesToRead, uint8_t* data)
{
    HAL_StatusTypeDef status = HAL_OK;

    switch (interface->interfaceType)
    {
        case WE_i2c:
#ifdef HAL_I2C_MODULE_ENABLED
            if ((interface->options.i2c.burstMode != 0) || (numBytesToRead == 1))
            {
                if (numBytesToRead > 1 && interface->options.i2c.useRegAddrMsbForMultiBytesRead)
                {
                    /* Register address most significant bit is used to enable multi bytes read */
                    regAdr |= 1 << 7;
                }
                status = I2Cx_ReadBytes((I2C_HandleTypeDef*)interface->handle, interface->options.i2c.address << 1, /* stm32 needs shifted value */
                                        (uint16_t)regAdr, numBytesToRead, interface->options.i2c.protocol, interface->options.readTimeout, data);
            }
            else
            {
                for (uint16_t i = 0; (i < numBytesToRead) && (status == HAL_OK); i++)
                {
                    status = I2Cx_ReadBytes((I2C_HandleTypeDef*)interface->handle, interface->options.i2c.address << 1, /* stm32 needs shifted value */
                                            regAdr + i, 1, interface->options.i2c.protocol, interface->options.readTimeout, data + i);
                }
            }
#else
            status = HAL_ERROR;
#endif /* HAL_I2C_MODULE_ENABLED */
            break;

        default:
            status = HAL_ERROR;
            break;
    }

    return status == HAL_OK ? WE_SUCCESS : WE_FAIL;
}

/**
 * @brief Write data starting from the addressed register
 * @param[in] interface Sensor interface
 * @param[in] regAdr Address of register to be written
 * @param[in] numBytesToWrite Number of bytes to write
 * @param[in] data Data to be written
 * @retval Error code
 */
inline int8_t WE_WriteReg(WE_sensorInterface_t* interface, uint8_t regAdr, uint16_t numBytesToWrite, uint8_t* data)
{
    HAL_StatusTypeDef status = HAL_OK;

    switch (interface->interfaceType)
    {

        case WE_i2c:
#ifdef HAL_I2C_MODULE_ENABLED
            if (interface->options.i2c.burstMode != 0 || numBytesToWrite == 1)
            {
                status = I2Cx_WriteBytes((I2C_HandleTypeDef*)interface->handle, interface->options.i2c.address << 1, /* stm32 needs shifted value */
                                         regAdr, numBytesToWrite, interface->options.i2c.protocol, interface->options.writeTimeout, data);
            }
            else
            {
                for (uint16_t i = 0; (i < numBytesToWrite) && (status == HAL_OK); i++)
                {
                    status = I2Cx_WriteBytes((I2C_HandleTypeDef*)interface->handle, interface->options.i2c.address << 1, /* stm32 needs shifted value */
                                             regAdr + i, 1, interface->options.i2c.protocol, interface->options.writeTimeout, data + i);
                }
            }
#else
            status = HAL_ERROR;
#endif /* HAL_I2C_MODULE_ENABLED */
            break;

        default:
            status = HAL_ERROR;
            break;
    }

    return status == HAL_OK ? WE_SUCCESS : WE_FAIL;
}

/**
 * @brief Checks if the sensor interface is ready.
 * @param[in] interface Sensor interface
 * @return WE_SUCCESS if interface is ready, WE_FAIL if not.
 */
int8_t WE_isSensorInterfaceReady(WE_sensorInterface_t* interface)
{
    switch (interface->interfaceType)
    {
        case WE_i2c:
#ifdef HAL_I2C_MODULE_ENABLED
            return (HAL_OK == HAL_I2C_IsDeviceReady((I2C_HandleTypeDef*)interface->handle, interface->options.i2c.address << 1, 64, 5000)) ? WE_SUCCESS : WE_FAIL;
#else
            return WE_FAIL;
#endif
        default:
            return WE_FAIL;
    }
}

#ifdef HAL_I2C_MODULE_ENABLED

/**
 * @brief Reads bytes from I2C
 * @param[in] handle I2C handle
 * @param[in] addr I2C address
 * @param[in] reg Register address
 * @param[in] numBytesToRead Number of bytes to read
 * @param[in] protocol I2C protocol
 * @param[in] timeout Timeout for read operation
 * @param[out] value Pointer to data buffer
 * @retval HAL status
 */
static HAL_StatusTypeDef I2Cx_ReadBytes(I2C_HandleTypeDef* handle, uint8_t addr, uint16_t reg, uint16_t numBytesToRead, WE_i2cProtocol_t protocol, uint16_t timeout, uint8_t* value)
{
    switch (protocol)
    {
        case WE_i2cProtocol_RegisterBased:
        {
            return HAL_I2C_Mem_Read(handle, addr, reg, I2C_MEMADD_SIZE_8BIT, value, numBytesToRead, timeout);
        }
        case WE_i2cProtocol_Raw:
        {
            return HAL_I2C_Master_Receive(handle, addr, value, numBytesToRead, timeout);
        }
        default:
            return HAL_ERROR;
    }
}

/**
 * @brief Writes bytes to I2C.
 * @param[in] handle I2C handle
 * @param[in] addr I2C address
 * @param[in] reg The target register address to write
 * @param[in] numBytesToWrite Number of bytes to write
 * @param[in] protocol I2C protocol
 * @param[in] timeout Timeout for write operation
 * @param[in] value The target register value to be written
 * @retval HAL status
 */
static HAL_StatusTypeDef I2Cx_WriteBytes(I2C_HandleTypeDef* handle, uint8_t addr, uint16_t reg, uint16_t numBytesToWrite, WE_i2cProtocol_t protocol, uint16_t timeout, uint8_t* value)
{
    switch (protocol)
    {
        case WE_i2cProtocol_RegisterBased:
        {
            return HAL_I2C_Mem_Write(handle, addr, reg, I2C_MEMADD_SIZE_8BIT, value, numBytesToWrite, timeout);
        }
        case WE_i2cProtocol_Raw:
        {
            return HAL_I2C_Master_Transmit(handle, addr, value, numBytesToWrite, timeout);
        }
        default:
            return HAL_ERROR;
    }
}

#endif /* HAL_I2C_MODULE_ENABLED */

/**
* @brief Delay function.
*
* @param[in] delay: Delay in milliseconds
*/
void WE_Delay(uint32_t delay) { HAL_Delay(delay); }


/* Debug output functions */
void debugPrint(char _out[]) {
    LOG("%s",_out);
}
void debugPrintln(char _out[])
{
    LOG("%s",_out);
}
