MaxenceHeroux/H2GP-2026/(commit log)

2026-05-01 folder pcb
2026-05-01 add first layout
    [H30_controler_board.kicad_pcb, H30_controler_board.kicad_sch]
2026-05-06 upload V1
    [H30_controler_board.kicad_pcb, H30_controler_board.kicad_sch]
2026-05-22 PCB V1.1
    [H30_controler_board.kicad_pcb, H30_controler_board.kicad_sch]
2026-05-22 PCB V1.2
    [H30_controler_board.kicad_pcb]
2026-06-12 init projet stm32
2026-06-15 ajout fonctionnalités EV CC H30->ESC
2026-06-21 fan PWM + setup
2026-06-21 Code board / 5s
2026-06-23 LED RGB
2026-06-24 Tension sensor + Scan I2C
